kanaya/Pineapple2/hardware/logicboard/p2-001.pdf

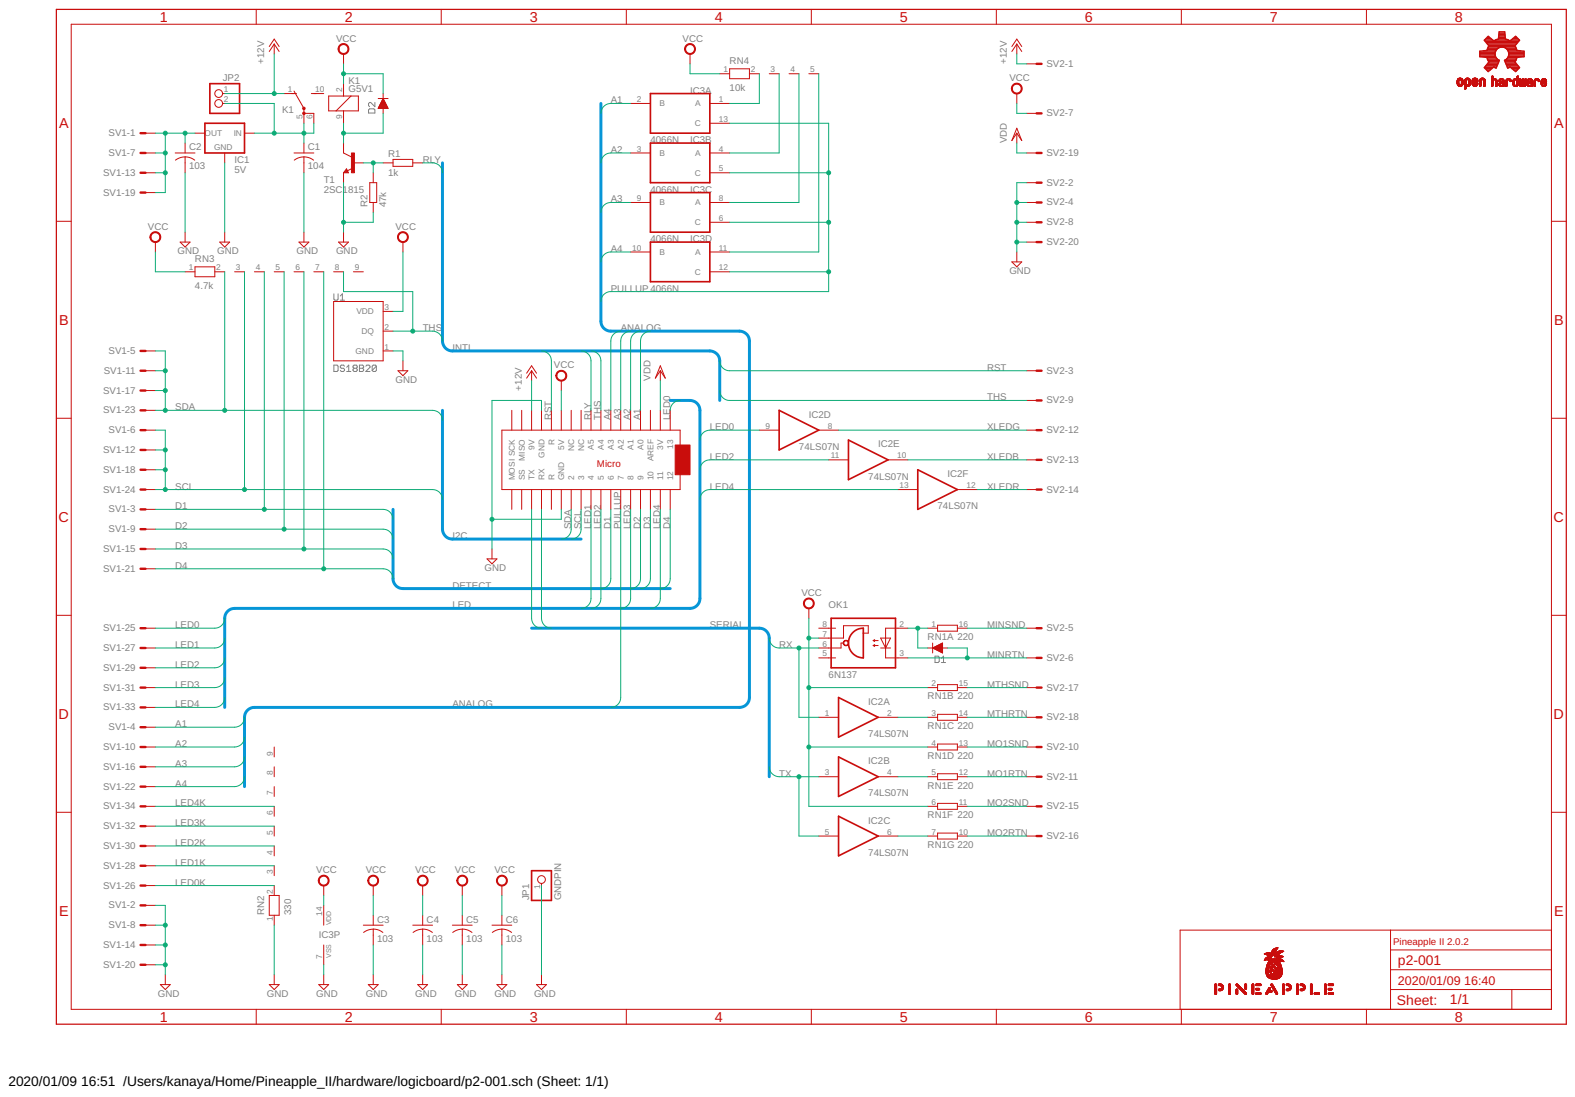
[picture p1: page 1]
