kanaya/Pineapple2/hardware/logicboard/p2-001.brd

## EAGLE design hardware/logicboard/p2-001.brd (2020-01-29)

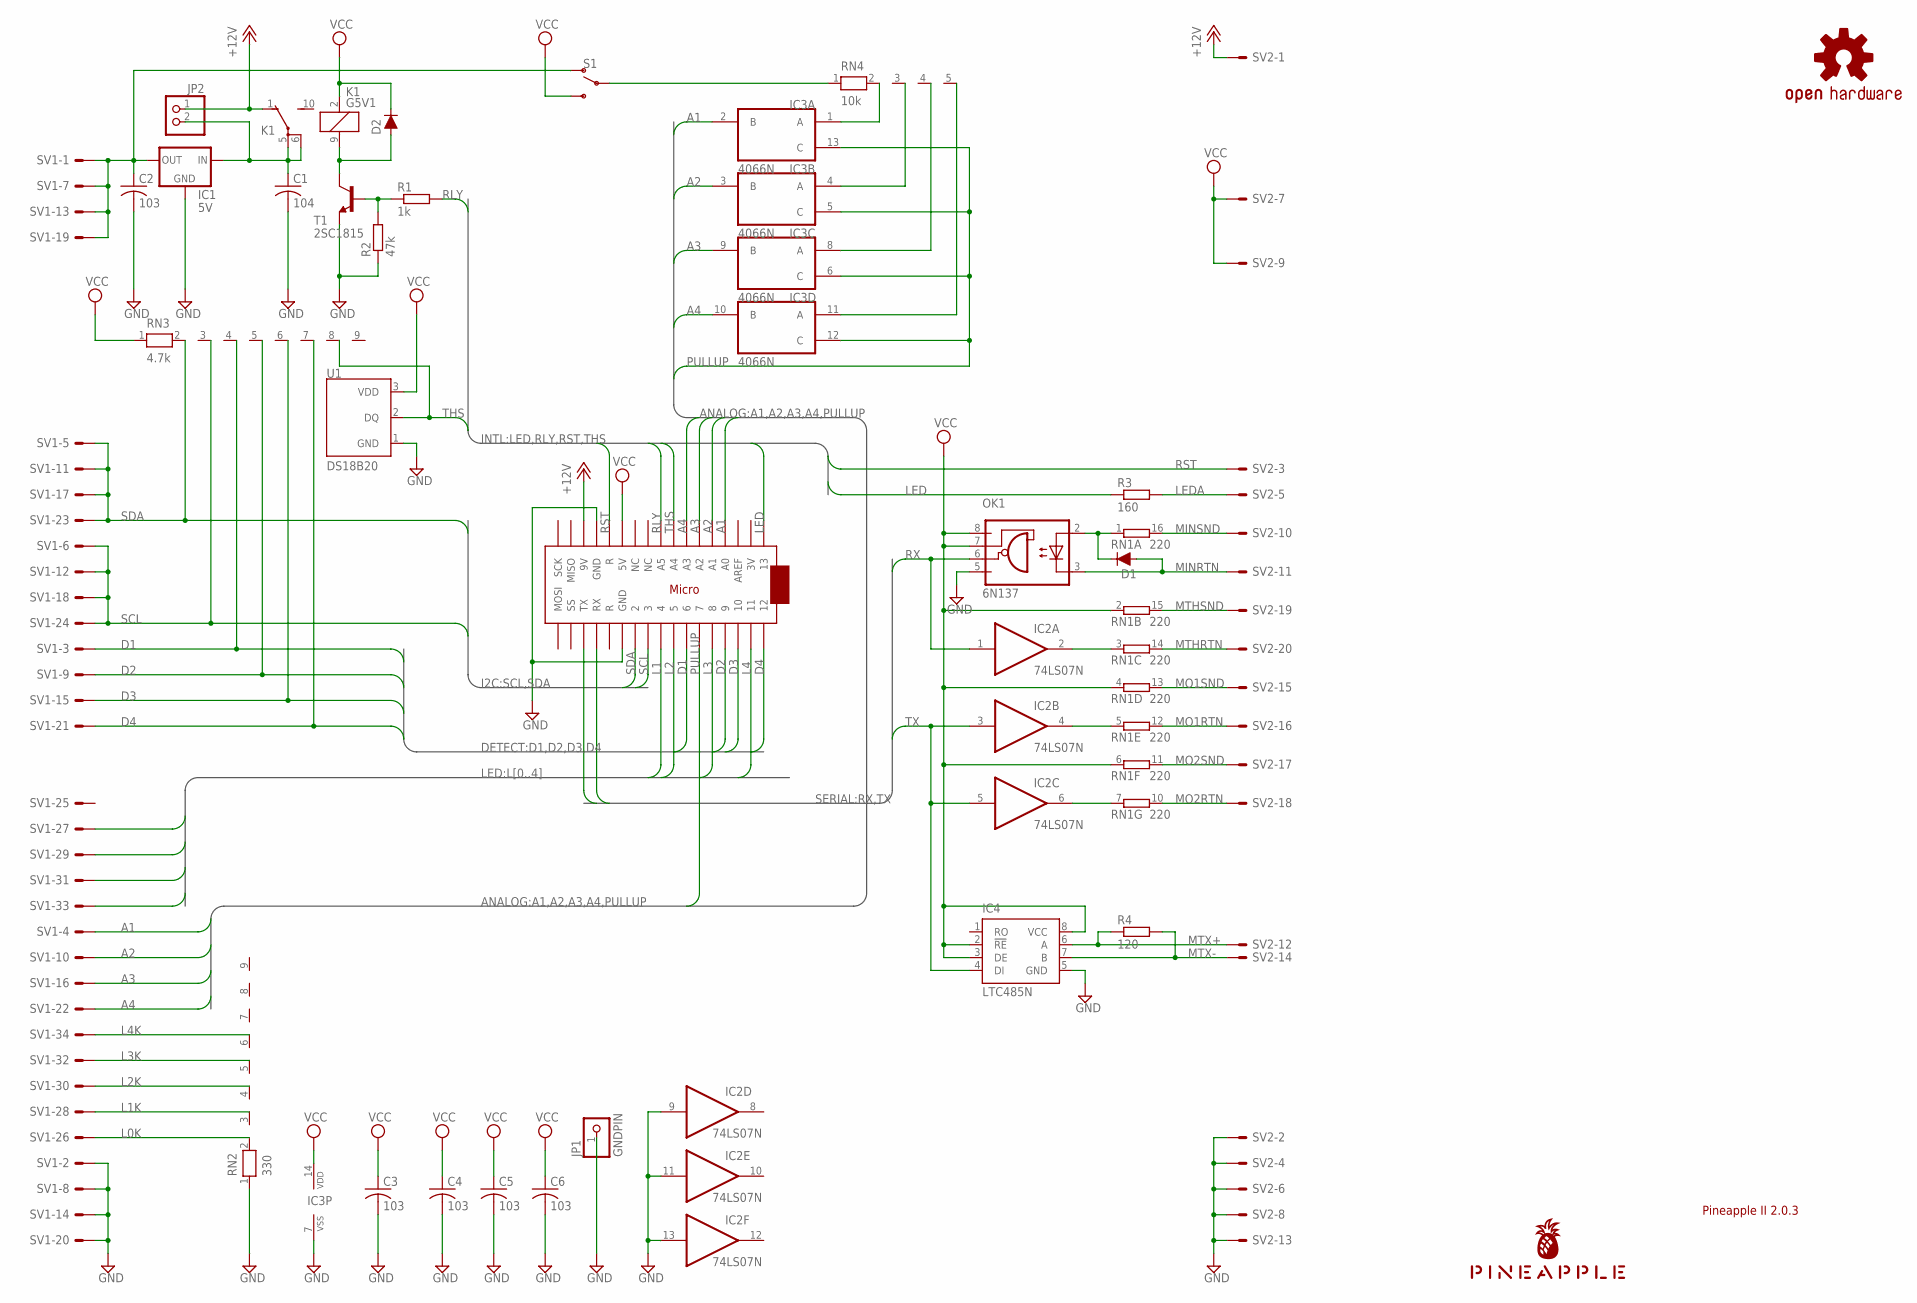
[picture p2: schematic p2-001.sch]

Parts:
C1: 104; C025-025X050
C2, C3, C4, C5, C6: 103; C025-025X050
D1, D2: DIODE-1N4148
IC1: 5V; 78XXL
IC2: 74LS07N; DIL14
IC3: 4066N; DIL14
IC4: LTC485N; DIL08
JP1: GNDPIN; 1X01
JP2: PINHD-1X2; 1X02
K1: G5V1
LOGO1: OSHW-LOGOS-COPPER; OSHW-LOGO-S_COPPER
MC1: ARDUINOMICRO
OK1: 6N137; DIL08
R1: 1k; 0204/5
R2: 47k; 0204/5
R3: 160; 0204/5
R4: 120; 0204/5
RN1: 220; DIL16
RN2: 330; RN-9
RN3: 4.7k; RN-9
RN4: 10k; RN-5
S1: SWITCH-SPDT-PTH-11.6X4.0MM; SWITCH_SPDT_PTH_11.6X4.0MM
SV1: ML34LE; ML34L
SV2: ML20LE; ML20L
T1: 2SC1815; TO92-ECB
U1: DS18B20; TO-92-AMMO
U$1: PINEAPPLE450_SILK

Connections:
A1: IC3.2 (B), MC1.P$31 (A0), SV1.4
A2: IC3.3 (B), MC1.P$30 (A1), SV1.10
A3: IC3.9 (B), MC1.P$29 (A2), SV1.16
A4: IC3.10 (B), MC1.P$28 (A3), SV1.22
D1: MC1.P$7 (6), RN3.4, SV1.3
D2: MC1.P$4 (9), RN3.5, SV1.9
D3: MC1.P$3 (10), RN3.6, SV1.15
D4: MC1.P$1 (12), RN3.7, SV1.21
GND: C1.2, C2.2, C3.2, C4.2, C5.2, C6.2, IC1.GND, IC2.7 (GND), IC2.9 (I), IC2.11 (I), IC2.13 (I), IC3.7 (VSS), IC4.5 (GND), JP1.1, MC1.P$12 (GND), MC1.P$21 (GND), OK1.5 (GND), R2.1, RN2.1, SV1.2, SV1.8, SV1.14, SV1.20, SV2.2, SV2.4, SV2.6, SV2.8, SV2.13, T1.E, U1.1 (GND)
L0K: RN2.2, SV1.26
L1: MC1.P$9 (4), SV1.27
L1K: RN2.3, SV1.28
L2: MC1.P$8 (5), SV1.29
L2K: RN2.4, SV1.30
L3: MC1.P$5 (8), SV1.31
L3K: RN2.5, SV1.32
L4: MC1.P$2 (11), SV1.33
L4K: RN2.6, SV1.34
LED: MC1.P$34 (13), R3.1
LEDA: R3.2, SV2.5
MIDIINSND: D1.C, OK1.2 (A), RN1.1
MIDIOUT2RTN: IC2.6 (O), RN1.7 (1)
MIDIOUTRTN: IC2.4 (O), RN1.5 (1)
MIDITHRURTN: IC2.2 (O), RN1.3 (1)
MINRTN: D1.A, OK1.3 (C), SV2.11
MINSND: RN1.16 (2), SV2.10
MO1RTN: RN1.12 (2), SV2.16
MO1SND: RN1.13 (2), SV2.15
MO2RTN: RN1.10 (2), SV2.18
MO2SND: RN1.11 (2), SV2.17
MTHRTN: RN1.14 (2), SV2.20
MTHSND: RN1.15 (2), SV2.19
MTX+: IC4.6 (A), R4.1, SV2.12
MTX-: IC4.7 (B), R4.2, SV2.14
unnamed: IC3.1 (A), RN4.2
unnamed: IC3.4 (A), RN4.3
unnamed: IC3.8 (A), RN4.4
unnamed: IC3.11 (A), RN4.5
PULLUP: IC3.5 (C), IC3.6 (C), IC3.12 (C), IC3.13 (C), MC1.P$6 (7)
RLY: MC1.P$26 (A5), R1.2
RLYDRV: R1.1, R2.2, T1.B
RLYSNK: D2.A, K1.9 (2), T1.C
RST: MC1.P$13 (R), SV2.3
RX: IC2.1 (I), MC1.P$14 (RX), OK1.6 (VO)
SCL: MC1.P$10 (3), RN3.3, SV1.6, SV1.12, SV1.18, SV1.24
SDA: MC1.P$11 (2), RN3.2, SV1.5, SV1.11, SV1.17, SV1.23
THS: MC1.P$27 (A4), RN3.8, U1.2 (DQ)
TX: IC2.3 (I), IC2.5 (I), IC4.4 (DI), MC1.P$15 (TX)
V+12V: C1.1, IC1.IN, JP2.2, K1.5, K1.6
VCC: C3.1, C4.1, C5.1, C6.1, D2.C, IC2.14 (VCC), IC3.14 (VDD), IC4.2 (!RE), IC4.3 (DE), IC4.8 (VCC), K1.2 (1), MC1.P$23 (5V), OK1.7 (VE), OK1.8 (VCC), RN1.2 (1), RN1.4 (1), RN1.6 (1), RN3.1, S1.3 (S), SV2.7, SV2.9, U1.3 (VDD)
VIN: JP2.1, K1.1 (O), MC1.P$20 (9V), SV2.1
VOUT: C2.1, IC1.OUT, S1.1 (O), SV1.1, SV1.7, SV1.13, SV1.19
VPULLUP: RN4.1, S1.2

Notes on the sheet:
Pineapple II 2.0.3

Board: 2 copper layers, 32 parts (0 on the bottom side), 53 nets, no tracks yet.
