kanaya/Pineapple2/peripheral/receiver/hardware/logicboard/p0-001.brd

## EAGLE design peripheral/receiver/hardware/logicboard/p0-001.brd (2020-01-29)

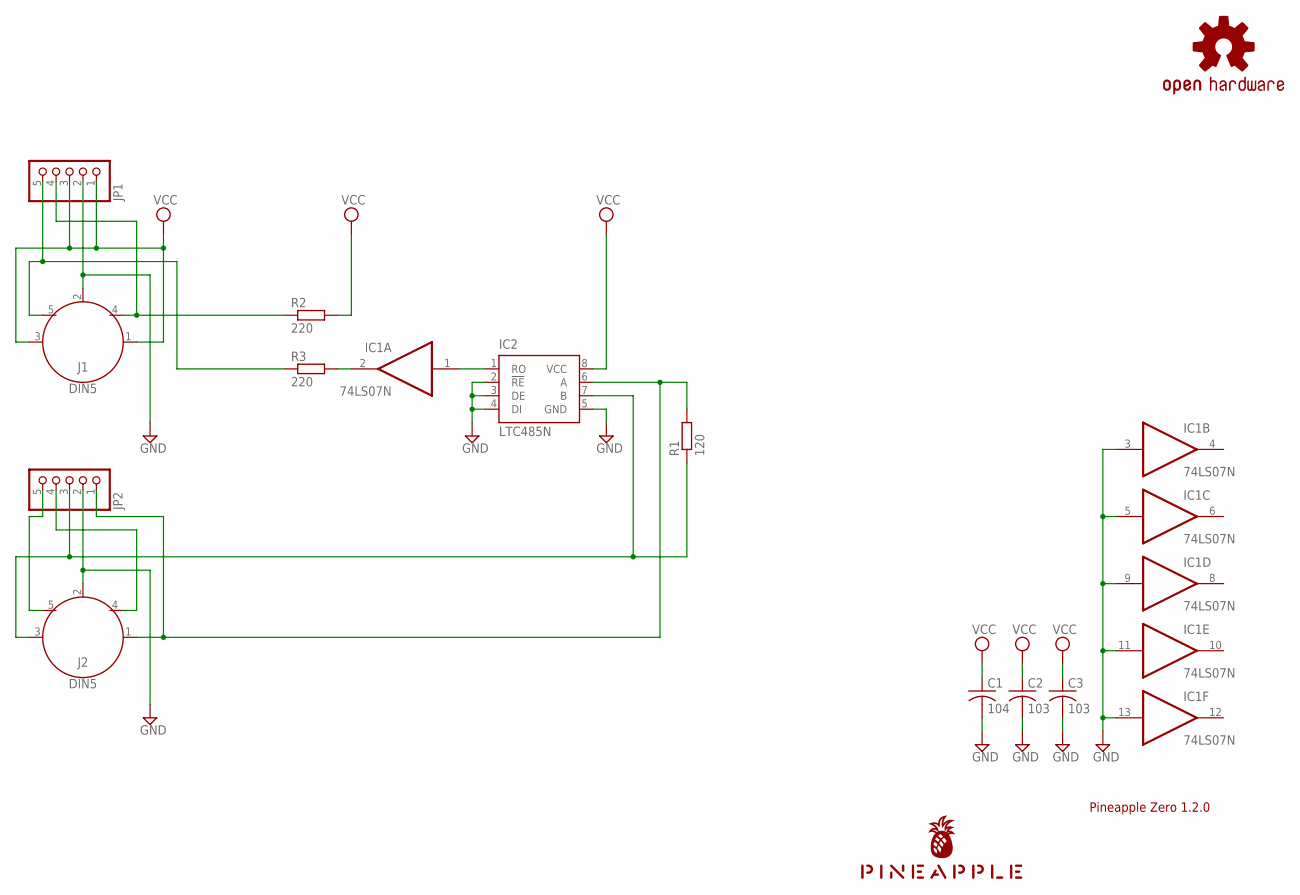
[picture p3: schematic p0-001.sch]

Parts:
C1: 104; C025-025X050
C2, C3: 103; C025-025X050
IC1: 74LS07N; DIL14
IC2: LTC485N; DIL08
J1, J2: DIN5; DIN5-RA-PTH
JP1, JP2: PINHD-1X5; 1X05
LOGO1: OSHW-LOGOS-COPPER; OSHW-LOGO-S_COPPER
R1: 120; 0204/5
R2, R3: 220; 0204/5
U$1: PINEAPPLE450

Connections:
DUMMY4: J2.4, JP2.4
DUMMY5: J2.5, JP2.5
GND: C1.2, C2.2, C3.2, IC1.3 (I), IC1.5 (I), IC1.7 (GND), IC1.9 (I), IC1.11 (I), IC1.13 (I), IC2.2 (!RE), IC2.3 (DE), IC2.4 (DI), IC2.5 (GND), J1.2, J2.2, JP1.2, JP2.2
MOUTRTN: J1.5, JP1.5, R3.1
MOUTSND: J1.4, JP1.4, R2.1
unnamed: IC1.2 (O), R3.2
RX+: IC2.6 (A), J2.1, JP2.1, R1.2
RX-: IC2.7 (B), J2.3, JP2.3, R1.1
TX: IC1.1 (I), IC2.1 (RO)
VCC: C1.1, C2.1, C3.1, IC1.14 (VCC), IC2.8 (VCC), J1.1, J1.3, JP1.1, JP1.3, R2.2

Notes on the sheet:
Pineapple Zero 1.2.0

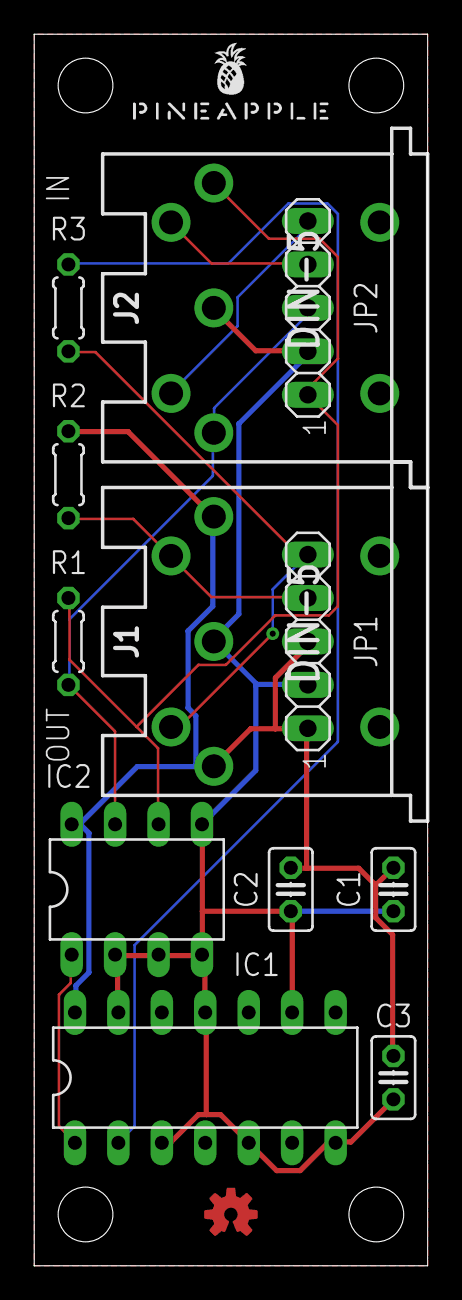
[picture p4: board p0-001.brd from above]

Board: 2 copper layers, 23.0 x 72.0 mm, 14 parts (0 on the bottom side), 10 nets.
