kanaya/Pineapple2/(commit log)

2020-01-05 Note on thermal sensor and breaker.
2020-01-06 Added missing frame of Panel 4.
2020-01-06 Almost brank schematic.
    [p2-001.sch]
2020-01-06 Refine of schematic and board.
    [p2-001.brd, p2-001.sch]
2020-01-07 Board design.
    [p2-001.brd, p2-001.sch]
2020-01-08 XLED terminals.
    [p2-001.brd, p2-001.sch]
2020-01-08 Fixed internal connector layouts.
2020-01-09 Clean up.
    [p2-001.brd, p2-001.sch]
2020-01-09 Added restricted area.
    [p2-001.brd]
2020-01-09 Clean up of schematic.
    [p2-001.sch]
2020-01-09 Version 2.0.0 -> 2.0.1
    [p2-001.sch]
2020-01-09 Nothing was changed except for silk.
    [p2-001.brd]
2020-01-09 Added PDF of schematic.
2020-01-09 Modified schematic and board for the better readability.
    [p2-001.brd, p2-001.sch]
2020-01-09 Real hotfix! Now pull-ups to Analog In are connected to Vout, not Vcc.
    [p2-001.brd, p2-001.sch]
2020-01-10 Added pull-up selector.
    [p2-001.brd, p2-001.sch]
2020-01-10 Jumper -> SW.
    [p2-001.brd, p2-001.sch]
2020-01-11 Changed netclass of VPULLUP to power.
    [p2-001.brd, p2-001.sch]
2020-01-11 Replaced back-panel SW to LEDSW. Now Back port is incompatible to 2.0.0-X.
    [p2-001.brd, p2-001.sch]
2020-01-11 Changed diamiter of thecenter-upper hole of the back-panel to 8.2mm so that it can hold LEDSW.
2020-01-12 Added RS-422 TX driver.
    [p2-001.brd, p2-001.sch]
2020-01-12 Fixed unconnected wires.
    [p2-001.brd, p2-001.sch]
2020-01-12 Imported schematic of Pineapple Zero.
    [p0-001.brd, p0-001.sch]
2020-01-12 Added DX receiver.
    [p0-001.brd, p0-001.sch]
2020-01-12 Now pin 3 of MIDI In is connected to Vcc.
    [p2-001.brd, p2-001.sch]
2020-01-12 Alternative Qi connectors.
    [p0-001.brd, p0-001.sch]
2020-01-12 Fixed description of MIDI connectors.
2020-01-13 Minor fix of silk.
    [p2-001.brd]
2020-01-25 Fixed connection of TLP552 to the power pins.
    [p2-001.brd, p2-001.sch]
2020-01-25 Moved Arduino Micro downward so that it can safely hold USB connector.
    [p2-001.brd]
2020-01-25 Changed fonts for better looking.
    [p2-001.brd]
2020-01-25 "PINEAPPLE.CC" on the back surface.
    [p2-001.brd]
2020-01-27 Moved Arduino Micro downward.
    [p2-001.brd, p2-001.sch]
2020-01-27 Optimized PCB layout.
    [p2-001.brd]
2020-01-27 Back LED is now connected to D13 (again).
    [p2-001.brd, p2-001.sch]
